pranav-labhe/RoboAssistant/cad/stl/5_back_access_door.stl

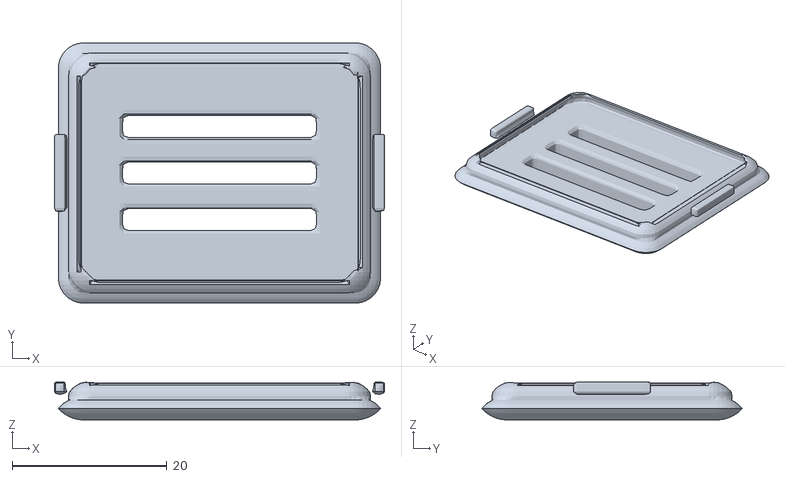
[picture p17: CAD file, 2026-11-04]
cad/stl/5_back_access_door.stl
42.6 x 33.6 x 4.90
