pranav-labhe/RoboAssistant/cad/stl/4_torso_shell.stl

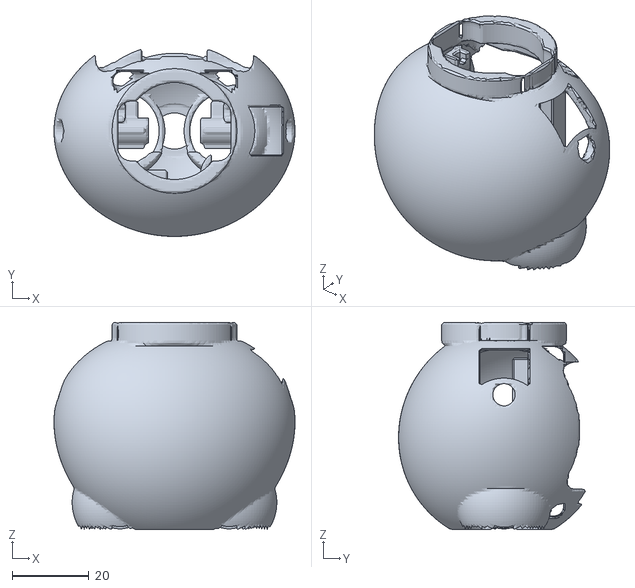
[picture p18: CAD file, 2026-11-04]
cad/stl/4_torso_shell.stl
62.6 x 48.6 x 53.8
