pranav-labhe/RoboAssistant/cad/stl/1_head_shell.stl

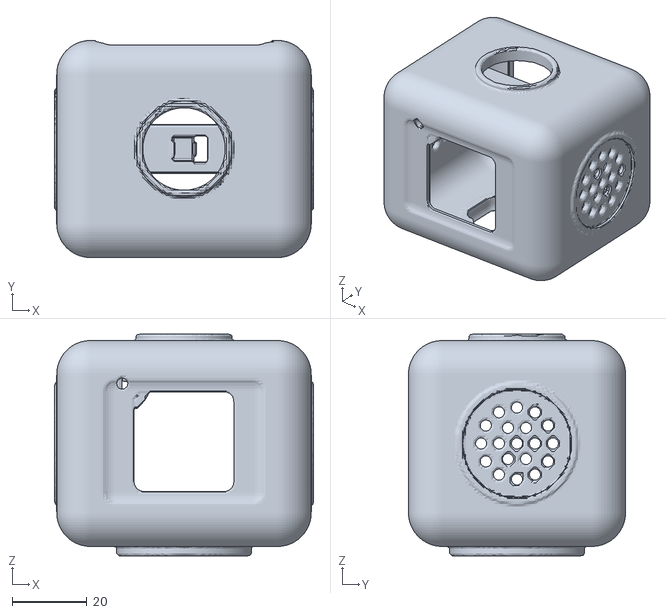
[picture p19: CAD file, 2026-11-04]
cad/stl/1_head_shell.stl
69.2 x 58.0 x 59.2
