pranav-labhe/RoboAssistant/cad/stl/2_front_visor_bezel.stl

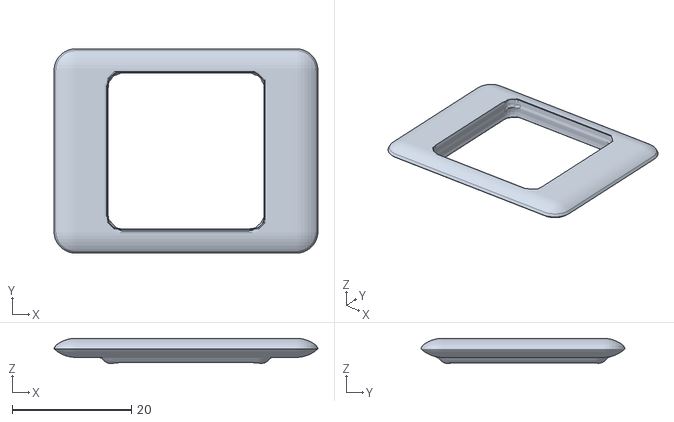
[picture p20: CAD file, 2026-11-04]
cad/stl/2_front_visor_bezel.stl
44.3 x 34.3 x 4.25
