pranav-labhe/RoboAssistant/cad/stl/6_arms_left_and_right.stl

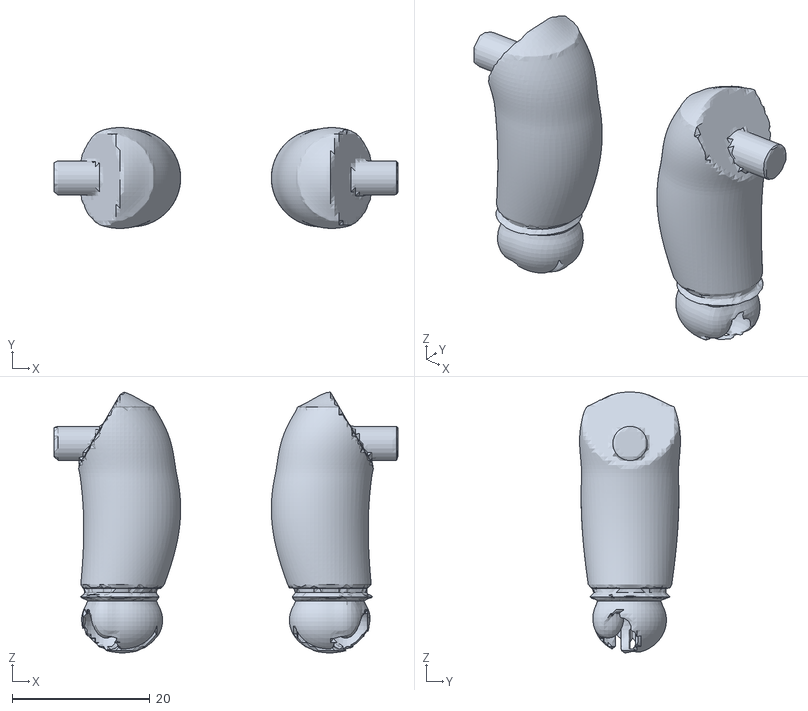
[picture p21: CAD file, 2026-11-04]
cad/stl/6_arms_left_and_right.stl
50.0 x 14.7 x 37.9
