pranav-labhe/RoboAssistant/cad/stl/3_top_ptt_button_cap.stl

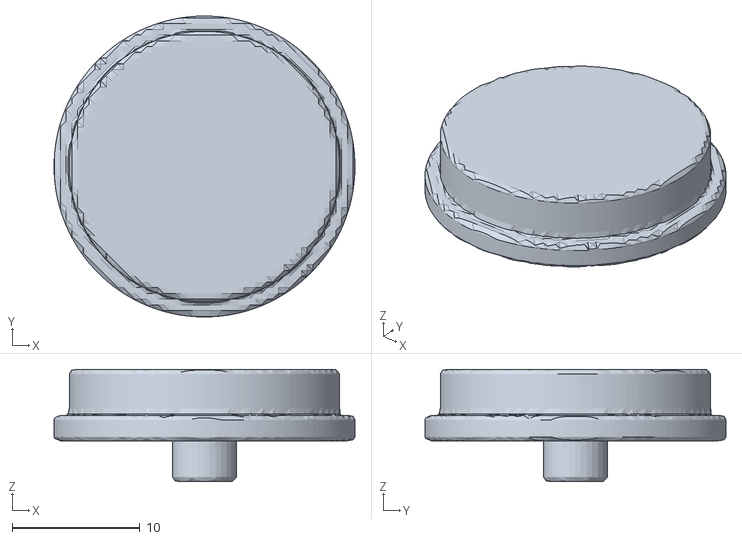
[picture p22: CAD file, 2026-11-04]
cad/stl/3_top_ptt_button_cap.stl
23.6 x 23.6 x 8.80
