pranav-labhe/RoboAssistant/cad/stl/8_feet_left_and_right.stl

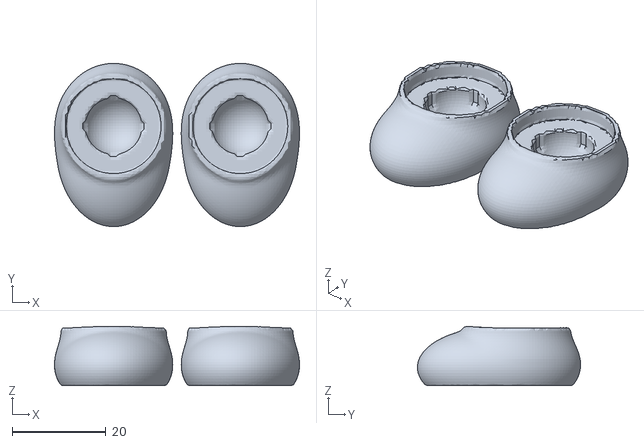
[picture p23: CAD file, 2026-11-04]
cad/stl/8_feet_left_and_right.stl
52.2 x 34.8 x 12.7
