pranav-labhe/RoboAssistant/cad/stl/7_thighs_left_and_right.stl

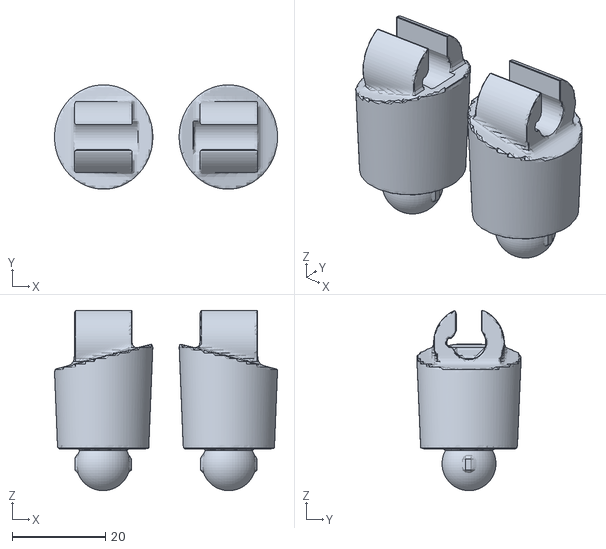
[picture p24: CAD file, 2026-11-04]
cad/stl/7_thighs_left_and_right.stl
47.9 x 22.4 x 38.7
