pranav-labhe/RoboAssistant/cad/stl/4_torso_and_feet.stl

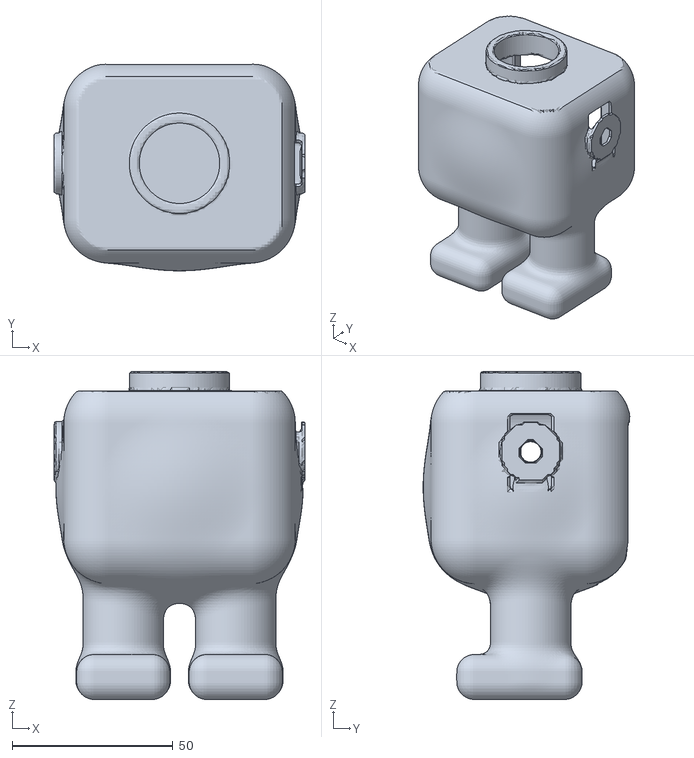
[picture p25: CAD file, 2026-11-04]
cad/stl/4_torso_and_feet.stl
78.0 x 64.3 x 102.0
