pranav-labhe/RoboAssistant/(commit log)

2026-10-28 feat: complete ESP32-S3 12-gate voice robot firmware & provider-agnostic voice gateway
2026-10-28 fix: portable ~/.robo_secrets discovery, per-device X-Session-Id isolation & upstream timeout/error tests
2026-10-28 docs: add comprehensive how-to guide, wiring table, and file-by-file reference in README.md
2026-10-28 docs: ground hardware recommendation table strictly to existing code defaults (zero code modifications)
2026-10-28 chore(hardware): align 7-pin ST7789 display default and add passives pack to BOM
2026-10-28 docs(readme): align Step 3 wiring table SD pin note with hardware reference table
2026-10-29 docs(hardware): add pre-soldered alternatives and zero-iron cost estimate table
2026-10-30 docs(readme): add hero banner, hardware-code linkage map, and step-by-step assembly guide
2026-10-30 docs(readme): add photorealistic breadboard wiring tutorial suite and breadboard anatomy guide
2026-10-30 docs(readme): add wire connectors tutorial photo and ESP32 breadboard placement image for Gate 1
2026-11-01 docs(hardware): update BOM delivery status for ESP32-S3 N16R8
2026-11-01 docs(hardware): simplify BOM status to clean checkmarks
2026-11-04 docs(readme): add 40-pin male berg strip link and distinguish 7-pin vs 8-pin ST7789 ASINs
2026-11-04 feat(robot): add expressive face states ([WAVE]/[HAPPY]/[SURPRISED]/[SAD]), non-blocking servo wave, and mark BOM ordered
2026-11-04 feat(cad): add 180mm 3D-printable robot enclosure STL package and internal hardware mounts
2026-11-04 feat(cad): split torso and legs into movable click-detent hips, thighs, and swivel/tilt ankles (8 STL parts)
2026-11-04 feat(cad): sculpt true oval belly with 2.8mm lightweight shell, recessed crescent hip joints, and VSA TechnoServices guide
2026-11-04 feat(cad): match reference photo arms, hands (thumb + curled fingers), tall thighs with angled hip seams, and domed shoes
2026-11-04 feat(cad): scale robot enclosure to 135mm (13.5cm) compact tabletop size while preserving 1:1 hardware mounts (~92g PLA)
2026-11-04 feat(cad): add built-in snap-retention clips for all components and guaranteed 1:1 clearance for 48mm speaker + 65mm ESP32-S3
2026-11-05 docs: add master circuit schematic and pinout interconnect guide
2026-11-05 docs: add comprehensive flowchart.md beside every main.cpp
2026-11-05 docs: add host laptop and wireless gateway link to circuit diagram
